emanuelelaface/AmigaBlueKick/PRIVACY.md

# Privacy

Apple requires a privacy disclaimer to submit applications to their store, so this is the one for Apple Blue Kick.

The app does not save any data, doesn’t connect to the Internet, does not send any data to anyone,
is a simple bluetooth client for the ESP32 switch on the Amiga Kickstart.

No data is shared with anyone for profiling, advertisements, marketing or any other service.
