emanuelelaface/AmigaBlueKick/(threads)

Thread 2 (2025-07-28):

Wrong Schematics

Mingo12, 2025-07-28:
Hi! I think the wiring is wrong. The positive and negative wires of the ESP32 Mini are inverted. This will destroy the ESP. The correct wiring would be:

On the EPROM 27C160
VSS = Negative
VCC = Positive

Closed 2025-07-28.
