emanuelelaface/AmigaBlueKick/images/IMG_9770.JPG

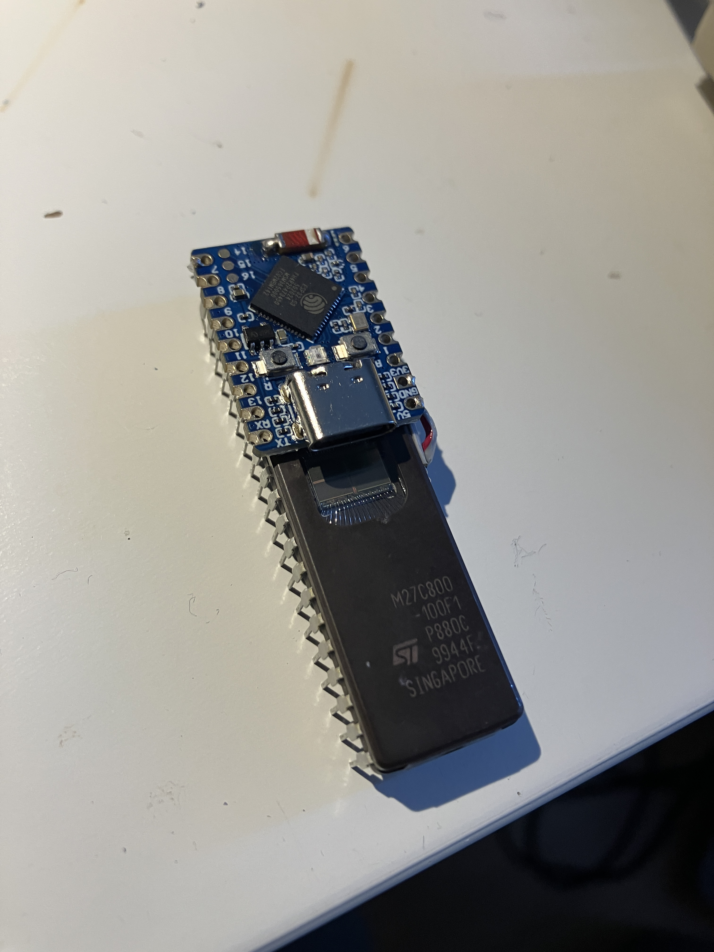
[picture p2: images/IMG_9770.JPG]
images/IMG_9770.JPG
