emanuelelaface/AmigaBlueKick/images/IMG_9772.JPG

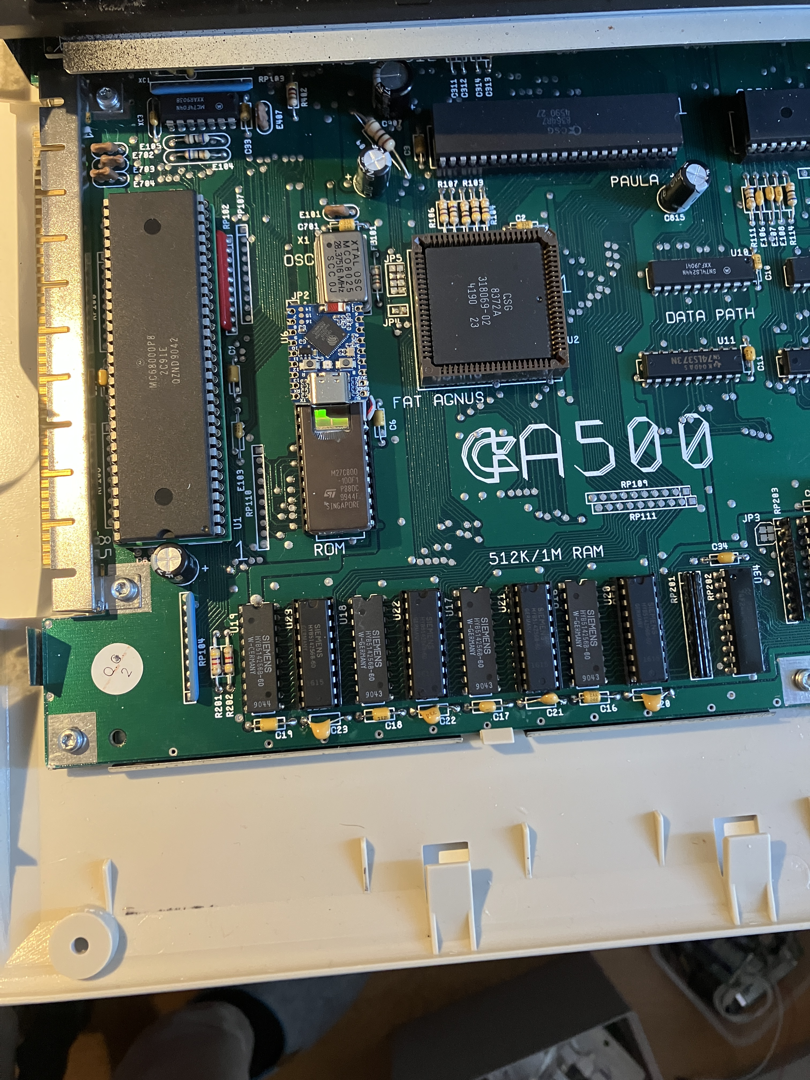
[picture p4: images/IMG_9772.JPG]
images/IMG_9772.JPG
